duodiscus92/projet-ouah/datasheets/upduino-pinout.png

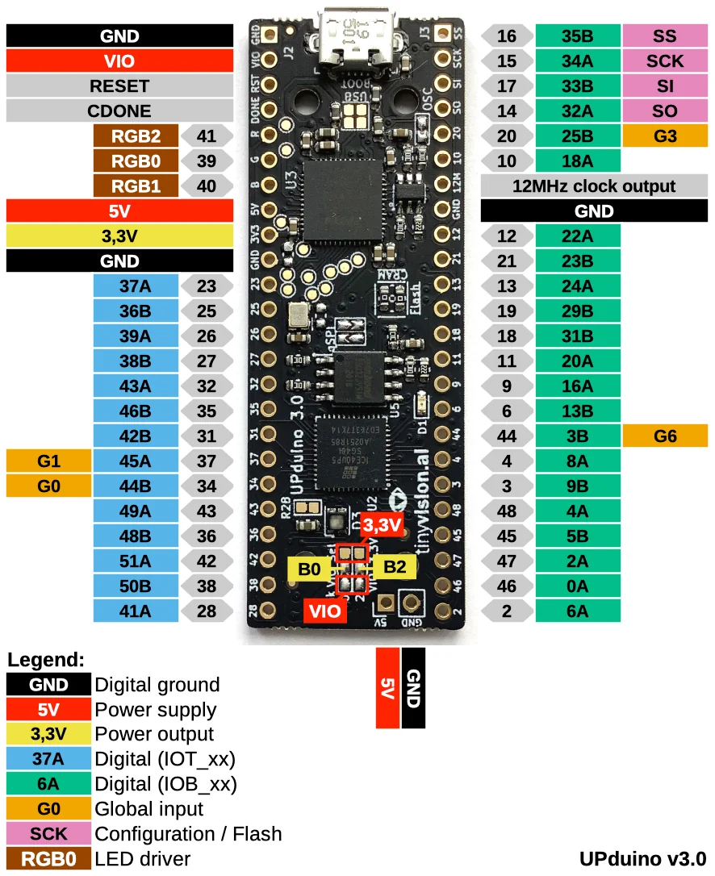
datasheets/upduino-pinout.png
