duodiscus92/projet-ouah/kicad/rapport-equipotentielles.csv

Net Code | Nom Équipot | Nombre de Pads | Nombre de Vias | Longueur de Via | Longueur de Segment | Dist. Pad à Chip | Longueur Net
001 | Net-(C1-Pad1) | 3 | 0 | 0,0000 mm | 28,2006 mm | 0,0000 mm | 28,2006 mm
002 | GND | 21 | 0 | 0,0000 mm | 298,6810 mm | 0,0000 mm | 298,6810 mm
003 | +9V | 4 | 0 | 0,0000 mm | 15,5298 mm | 0,0000 mm | 15,5298 mm
004 | +5V | 5 | 1 | 1,5450 mm | 110,4767 mm | 0,0000 mm | 112,0217 mm
005 | Net-(D1-Pad2) | 2 | 0 | 0,0000 mm | 8,7160 mm | 0,0000 mm | 8,7160 mm
006 | Net-(D1-Pad4) | 2 | 0 | 0,0000 mm | 40,1498 mm | 0,0000 mm | 40,1498 mm
007 | Net-(D4-Pad2) | 2 | 0 | 0,0000 mm | 5,8661 mm | 0,0000 mm | 5,8661 mm
008 | Net-(D5-Pad2) | 2 | 0 | 0,0000 mm | 5,8781 mm | 0,0000 mm | 5,8781 mm
009 | Net-(D6-Pad2) | 2 | 0 | 0,0000 mm | 5,8781 mm | 0,0000 mm | 5,8781 mm
010 | Net-(D7-Pad2) | 2 | 0 | 0,0000 mm | 5,8760 mm | 0,0000 mm | 5,8760 mm
011 | Net-(D8-Pad2) | 2 | 0 | 0,0000 mm | 5,8781 mm | 0,0000 mm | 5,8781 mm
012 | Net-(D9-Pad2) | 2 | 0 | 0,0000 mm | 5,8760 mm | 0,0000 mm | 5,8760 mm
013 | Net-(D10-Pad2) | 2 | 0 | 0,0000 mm | 5,8781 mm | 0,0000 mm | 5,8781 mm
014 | /R_DCF77 | 2 | 0 | 0,0000 mm | 19,5484 mm | 0,0000 mm | 19,5484 mm
015 | /S_DCF77 | 2 | 0 | 0,0000 mm | 13,0167 mm | 0,0000 mm | 13,0167 mm
016 | Net-(D13-Pad2) | 2 | 0 | 0,0000 mm | 5,4669 mm | 0,0000 mm | 5,4669 mm
018 | /DCF77 | 2 | 0 | 0,0000 mm | 112,5843 mm | 0,0000 mm | 112,5843 mm
019 | /cs3 | 2 | 4 | 6,1800 mm | 102,3684 mm | 0,0000 mm | 108,5484 mm
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
077 | Net-(F1-Pad1) | 2 | 0 | 0,0000 mm | 13,0006 mm | 0,0000 mm | 13,0006 mm
078 | Net-(F1-Pad2) | 2 | 0 | 0,0000 mm | 10,7071 mm | 0,0000 mm | 10,7071 mm
079 | Net-(J2-Pad3) | 2 | 0 | 0,0000 mm | 40,4527 mm | 0,0000 mm | 40,4527 mm
