duodiscus92/projet-ouah/kicad/Ouah 3D.jpg

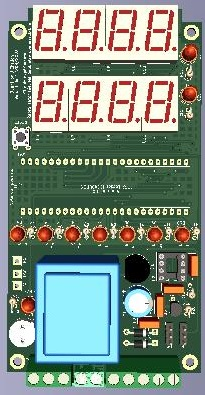
kicad/Ouah 3D.jpg
