duodiscus92/projet-ouah/documentation/bom.xls

Column2 | Column3 | Column4 | Column5 | Column6 | Column7
Qty | Reference(s) | Value | LibPart | Footprint | Datasheet
1 | C1 | 470 uF | Device:C_Polarized | Capacitor_THT:CP_Radial_D10.0mm_P5.00mm | ~
1 | C2 | 100 nF | Device:C | Capacitor_THT:C_Rect_L7.2mm_W2.5mm_P5.00mm_FKS2_FKP2_MKS2_MKP2 | ~
2 | C3, C6 | 100 nF | Device:C | Capacitor_THT:C_Rect_L7.2mm_W2.5mm_P5.00mm_FKS2_FKP2_MKS2_MKP2 | ~
1 | C4 | 100nF | Device:C | Capacitor_THT:C_Rect_L7.2mm_W2.5mm_P5.00mm_FKS2_FKP2_MKS2_MKP2 | ~
1 | C5 | 100nF | Device:C | Capacitor_THT:C_Rect_L7.2mm_W2.5mm_P5.00mm_FKS2_FKP2_MKS2_MKP2 | ~
1 | D1 | B250C1500G | Diode_Bridge:B250C1500G | Diode_THT:Diode_Bridge_Round_D9.8mm | https://www.vishay.com/docs/88501/b40c1500g.pdf
1 | D2 | 1N4007 | Diode:1N4007 | Diode_THT:D_DO-41_SOD81_P10.16mm_Horizontal | http://www.vishay.com/docs/88503/1n4001.pdf
1 | D3 | 1N4007 | Diode:1N4007 | Diode_THT:D_DO-41_SOD81_P10.16mm_Horizontal | http://www.vishay.com/docs/88503/1n4001.pdf
1 | D4 | LED | Device:LED | LED_THT:LED_D5.0mm | ~
1 | D5 | LED | Device:LED | LED_THT:LED_D5.0mm | ~
1 | D6 | LED | Device:LED | LED_THT:LED_D5.0mm | ~
1 | D7 | LED | Device:LED | LED_THT:LED_D5.0mm | ~
1 | D8 | LED | Device:LED | LED_THT:LED_D5.0mm | ~
1 | D9 | LED | Device:LED | LED_THT:LED_D5.0mm | ~
1 | D10 | LED | Device:LED | LED_THT:LED_D5.0mm | ~
1 | D11 | LED | Device:LED | LED_THT:LED_D5.0mm | ~
1 | D12 | LED | Device:LED | LED_THT:LED_D5.0mm | ~
1 | D13 | LED | Device:LED | LED_THT:LED_D5.0mm | ~
1 | F1 | LITT 37201000411 | Fusible radial 100 mA retardé | Fuse:Fuseholder_TR5_Littelfuse_No560_No460 | ~
1 | J1 | Screw_Terminal_01x05 | Bornier à vis 5 pôles | TerminalBlock:TerminalBlock_bornier-5_P5.08mm | ~
1 | J2 | Screw_Terminal_01x03 | Bornier à vis 3 pôles | TerminalBlock:TerminalBlock_bornier-3_P5.08mm | ~
1 | J3 | Screw_Terminal_01x02 | Bornier à vis 2 pôles | TerminalBlock:TerminalBlock_bornier-2_P5.08mm | ~
1 | JP1 | Jumper_3_Open | Jumper:Jumper_3_Open | Connector_PinHeader_2.54mm:PinHeader_1x03_P2.54mm_Vertical | ~
1 | JP2 | Jumper_3_Open | Jumper:Jumper_3_Open | Connector_PinHeader_2.54mm:PinHeader_1x03_P2.54mm_Vertical | ~
1 | JP3 | Jumper_2_Open | Jumper:Jumper_2_Open | Connector_PinHeader_2.54mm:PinHeader_1x02_P2.54mm_Vertical | ~
1 | R1 | 150 ohms | Device:R | Resistor_THT:R_Axial_DIN0207_L6.3mm_D2.5mm_P7.62mm_Horizontal | ~
1 | R2 | 150 ohms | Device:R | Resistor_THT:R_Axial_DIN0207_L6.3mm_D2.5mm_P7.62mm_Horizontal | ~
1 | R3 | 150 ohms | Device:R | Resistor_THT:R_Axial_DIN0207_L6.3mm_D2.5mm_P2.54mm_Vertical | ~
1 | R4 | 150 ohms | Device:R | Resistor_THT:R_Axial_DIN0207_L6.3mm_D2.5mm_P7.62mm_Horizontal | ~
1 | R5 | 150 ohms | Device:R | Resistor_THT:R_Axial_DIN0207_L6.3mm_D2.5mm_P7.62mm_Horizontal | ~
1 | R6 | 150 ohms | Device:R | Resistor_THT:R_Axial_DIN0207_L6.3mm_D2.5mm_P2.54mm_Vertical | ~
1 | R7 | 150 ohms | Device:R | Resistor_THT:R_Axial_DIN0207_L6.3mm_D2.5mm_P2.54mm_Vertical | ~
1 | R8 | 150 ohms | Device:R | Resistor_THT:R_Axial_DIN0207_L6.3mm_D2.5mm_P2.54mm_Vertical | ~
1 | R9 | 150 ohms | Device:R | Resistor_THT:R_Axial_DIN0207_L6.3mm_D2.5mm_P7.62mm_Horizontal | ~
1 | R10 | 150 ohms | Device:R | Resistor_THT:R_Axial_DIN0207_L6.3mm_D2.5mm_P7.62mm_Horizontal | ~
1 | R11 | 150 ohms | Device:R | Resistor_THT:R_Axial_DIN0207_L6.3mm_D2.5mm_P2.54mm_Vertical | ~
1 | R12 | 150 ohms | Device:R | Resistor_THT:R_Axial_DIN0207_L6.3mm_D2.5mm_P2.54mm_Vertical | ~
1 | R13 | 150 ohms | Device:R | Resistor_THT:R_Axial_DIN0207_L6.3mm_D2.5mm_P2.54mm_Vertical | ~
1 | R14 | 150 ohms | Device:R | Resistor_THT:R_Axial_DIN0207_L6.3mm_D2.5mm_P7.62mm_Horizontal | ~
1 | R15 | 150 ohms | Device:R | Resistor_THT:R_Axial_DIN0207_L6.3mm_D2.5mm_P7.62mm_Horizontal | ~
1 | R16 | 150 ohms | Device:R | Resistor_THT:R_Axial_DIN0207_L6.3mm_D2.5mm_P2.54mm_Vertical | ~
1 | R17 | 150 ohms | Device:R | Resistor_THT:R_Axial_DIN0207_L6.3mm_D2.5mm_P2.54mm_Vertical | ~
1 | R18 | 150 ohms | Device:R | Resistor_THT:R_Axial_DIN0207_L6.3mm_D2.5mm_P2.54mm_Vertical | ~
1 | R19 | 10k | Device:R | Resistor_THT:R_Axial_DIN0207_L6.3mm_D2.5mm_P2.54mm_Vertical | ~
1 | R20 | 10k | Device:R | Resistor_THT:R_Axial_DIN0207_L6.3mm_D2.5mm_P2.54mm_Vertical | ~
1 | SW1 | SW_Push | Switch:SW_Push | Button_Switch_THT:SW_PUSH_6mm | ~
1 | T1 | BLOCK VB 1,0/1/9 | Device:Transformer_1P_1S | Library:Transformer_CHK_EI30-2VA_1xSec_RevEHR | ~
1 | TP1 | TestPoint | Connector:TestPoint | TestPoint:TestPoint_THTPad_3.0x3.0mm_Drill1.5mm | ~
1 | TP2 | TestPoint | Connector:TestPoint | TestPoint:TestPoint_THTPad_3.0x3.0mm_Drill1.5mm | ~
1 | TP3 | TestPoint | Connector:TestPoint | TestPoint:TestPoint_THTPad_3.0x3.0mm_Drill1.5mm | ~
1 | U1 | Upduino31-v3 | Carte Upduino 3.0 | Library:DIP-48_W17.78mm_LongPads
1 | U2 | TL7705A | Power_Supervisor:TL7705A | Package_DIP:DIP-8_W7.62mm_Socket_LongPads | http://www.ti.com.cn/cn/lit/ds/symlink/tl7705a.pdf
1 | U3 | LP2950-5.0_TO92 | Regulator_Linear:LP2950-5.0_TO92 | Package_TO_SOT_THT:TO-92_Inline_Wide | http://www.ti.com/lit/ds/symlink/lp2951.pdf
1 | U4 | D168K | Afficheur 7 segment, cathode commune | Library:D1X8K_RevEHR | https://ia800903.us.archive.org/24/items/CTKD1x8K/Cromatek%20D168K.pdf
1 | U5 | D168K | Afficheur 7 segment, cathode commune | Library:D1X8K_RevEHR | https://ia800903.us.archive.org/24/items/CTKD1x8K/Cromatek%20D168K.pdf
1 | U6 | D168K | Afficheur 7 segment, cathode commune | Library:D1X8K_RevEHR | https://ia800903.us.archive.org/24/items/CTKD1x8K/Cromatek%20D168K.pdf
1 | U7 | D168K | Afficheur 7 segment, cathode commune | Library:D1X8K_RevEHR | https://ia800903.us.archive.org/24/items/CTKD1x8K/Cromatek%20D168K.pdf
1 | U8 | D168K | Afficheur 7 segment, cathode commune | Library:D1X8K_RevEHR | https://ia800903.us.archive.org/24/items/CTKD1x8K/Cromatek%20D168K.pdf
1 | U9 | D168K | Afficheur 7 segment, cathode commune | Library:D1X8K_RevEHR | https://ia800903.us.archive.org/24/items/CTKD1x8K/Cromatek%20D168K.pdf
1 | U10 | D168K | Afficheur 7 segment, cathode commune | Library:D1X8K_RevEHR | https://ia800903.us.archive.org/24/items/CTKD1x8K/Cromatek%20D168K.pdf
1 | U11 | D168K | Afficheur 7 segment, cathode commune | Library:D1X8K_RevEHR | https://ia800903.us.archive.org/24/items/CTKD1x8K/Cromatek%20D168K.pdf
Qty | Reference(s) | Value | LibPart | Footprint | Datasheet
1 | C1 | 470 uF | Condensateur polarisé | Capacitor_THT:CP_Radial_D10.0mm_P5.00mm | ~
4 | C2, C3 | 100 nF | Condensateurs | Capacitor_THT:C_Rect_L7.2mm_W2.5mm_P5.00mm_FKS2_FKP2_MKS2_MKP2 | ~
1 | D1 | B250C1500G | Pont à diodes | Diode_THT:Diode_Bridge_Round_D9.8mm | https://www.vishay.com/docs/88501/b40c1500g.pdf
2 | D2, D3 | 1N4007 | Diode:1N4007 | Diode_THT:D_DO-41_SOD81_P10.16mm_Horizontal | http://www.vishay.com/docs/88503/1n4001.pdf
10 | D4, D5, D6, D7, D8, D9, D10, D11, D12, D13 | LED | Device:LED | LED_THT:LED_D5.0mm | ~
1 | F1 | LITT 37201000411 | Fusible radial 100 mA retardé | Fuse:Fuseholder_TR5_Littelfuse_No560_No460 | ~
1 | J1 | Screw_Terminal_01x05 | Bornier à vis 5 pôles | TerminalBlock:TerminalBlock_bornier-5_P5.08mm | ~
1 | J2 | Screw_Terminal_01x03 | Bornier à vis 3 pôles | TerminalBlock:TerminalBlock_bornier-3_P5.08mm | ~
1 | J3 | Screw_Terminal_01x02 | Bornier à vis 2 pôles | TerminalBlock:TerminalBlock_bornier-2_P5.08mm | ~
2 | JP1, JP2 | Jumper_3_Open | Jumper:Jumper_3_Open | Connector_PinHeader_2.54mm:PinHeader_1x03_P2.54mm_Vertical | ~
1 | JP3 | Jumper_2_Open | Jumper:Jumper_2_Open | Connector_PinHeader_2.54mm:PinHeader_1x02_P2.54mm_Vertical | ~
8 | R1, R2, R4, R5, R9, R10, R14, R15 | 150 | Device:R | Resistor_THT:R_Axial_DIN0207_L6.3mm_D2.5mm_P7.62mm_Horizontal | ~
10 | R3, R6, R7, R8, R11, R12, R13, R16, R17, R18 | 150 | Device:R | Resistor_THT:R_Axial_DIN0207_L6.3mm_D2.5mm_P2.54mm_Vertical | ~
2 | R19, R20 | 10k | Device:R | Resistor_THT:R_Axial_DIN0207_L6.3mm_D2.5mm_P2.54mm_Vertical | ~
1 | SW1 | SW_Push | Bouton Push | Button_Switch_THT:SW_PUSH_6mm | ~
1 | T1 | BLOCK VB 1,0/1/9 | Device:Transformer_1P_1S | Library:Transformer_CHK_EI30-2VA_1xSec_RevEHR | ~
3 | TP1, TP2, TP3 | TestPoint | Connector:TestPoint | TestPoint:TestPoint_THTPad_3.0x3.0mm_Drill1.5mm | ~
1 | U1 | Upduino31-v3 | Carte Upduino 3.0 | Library:DIP-48_W17.78mm_LongPads
1 | U2 | TL7705A | Power_Supervisor:TL7705A | Package_DIP:DIP-8_W7.62mm_Socket_LongPads | http://www.ti.com.cn/cn/lit/ds/symlink/tl7705a.pdf
2 | U3, U12 | LP2950-5.0_TO92 | Regulator_Linear:LP2950-5.0_TO92 | Package_TO_SOT_THT:TO-92_Inline_Wide | http://www.ti.com/lit/ds/symlink/lp2951.pdf
8 | U4, U5, U6, U7, U8, U9, U10, U11 | D168K | Afficheurs 7 segments | Library:D1X8K_RevEHR | https://ia800903.us.archive.org/24/items/CTKD1x8K/Cromatek%20D168K.pdf
