duodiscus92/projet-ouah/documentation/passe-bande-butterworth-77500Hz.ASC

C1: cap; 0.026785µF; Rpar=153.338k
C2: cap; 1057.35pF; Rpar=3.884Meg
C3: cap; 0.026105µF; Rpar=157.336k
C4: cap; 680.507pF; Rpar=6.036Meg
C5: cap; 0.026105µF; Rpar=157.336k
C6: cap; 1057.35pF; Rpar=3.884Meg
C7: cap; 0.026785µF; Rpar=153.338k
L1: ind; 151.47µH; Rser=0.3687879
L3: ind; 151.47µH; Rser=0.3687879
L5: ind; 151.47µH; Rser=0.3687879
L7: ind; 151.47µH; Rser=0.3687879
RL: res; 1.25k
RS: res; 1.25k
Vgen: voltage; AC 2
Named nets: 0
.AC DEC 1000  50000  90000
Schematic drawn by Elsie
1
2
3
4
5
6
7
