duodiscus92/projet-ouah/documentation/passe-bas-80kHz.ASC

C1: cap; 0,024uF
C3: cap; 0,082uF
C5: cap; 0,024uF
L2: ind; 160uH; Rser=8,042477E-05
L4: ind; 160uH; Rser=8,042477E-05
RL: res; 50
RS: res; 50
Vgen: voltage; AC 2
