duodiscus92/projet-ouah/documentation/passe-haut-70kHz.ASC

C1: cap; 0,075uF
C3: cap; 0,022uF
C5: cap; 0,075uF
L2: ind; 70,2594uH; Rser=3,09017E-05
L4: ind; 70,2594uH; Rser=3,09017E-05
RL: res; 50
RS: res; 50
Vgen: voltage; AC 2
