duodiscus92/projet-ouah/kicad/Ouah.kicad_pcb

## KiCad design kicad/Ouah.kicad_pcb (2023-11-12)

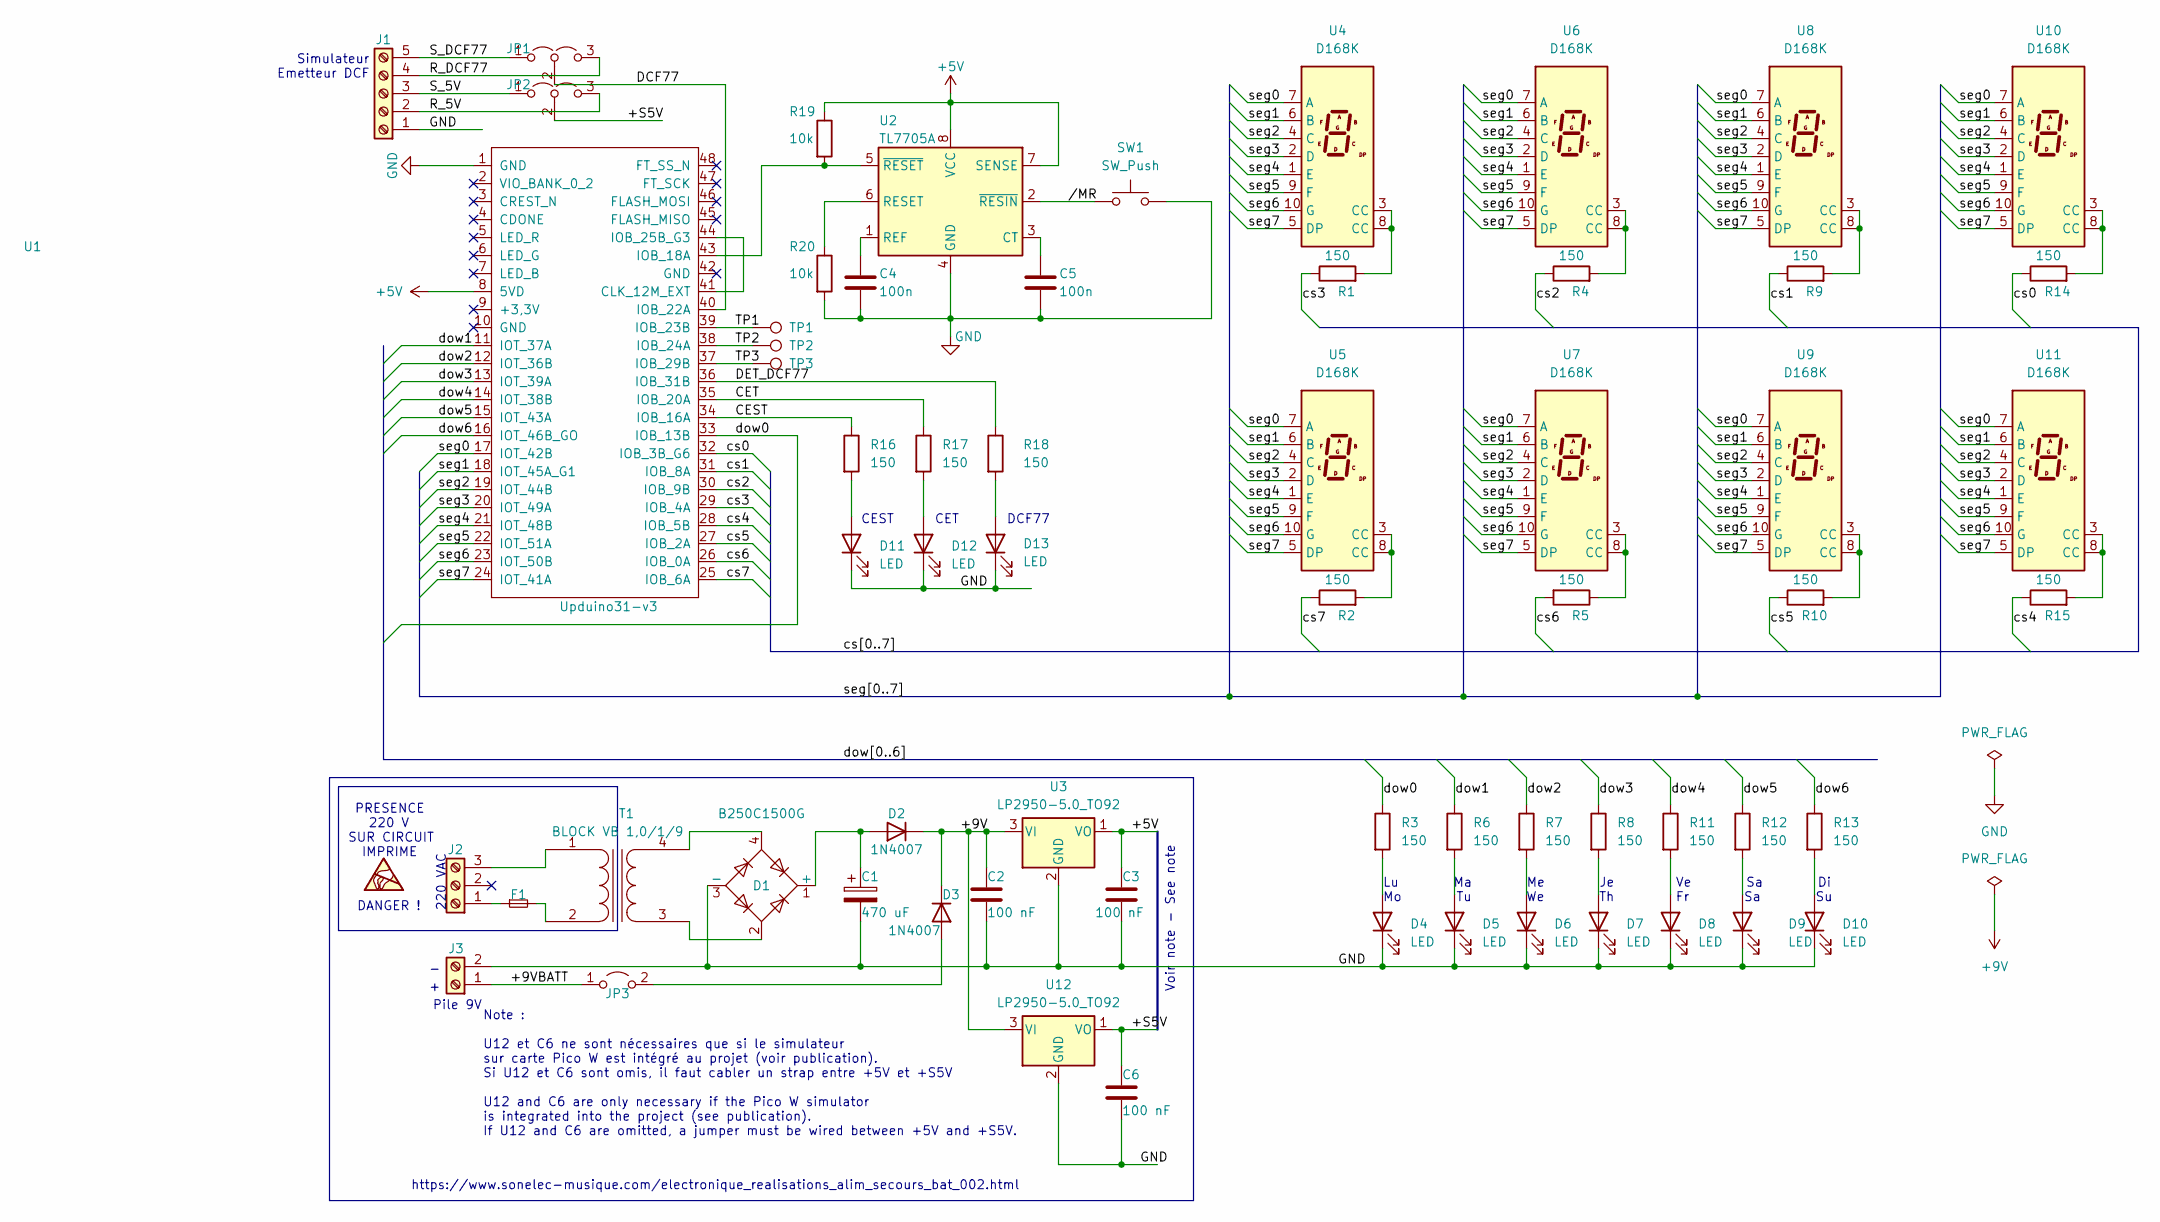
[picture p19: schematic Ouah.kicad_sch, Ouah ! (Oh ! Une Autre Horloge)]

Parts:
C1: 470 uF; CP_Radial_D10.0mm_P5.00mm
C2, C3, C6: 100 nF; C_Rect_L7.2mm_W2.5mm_P5.00mm_FKS2_FKP2_MKS2_MKP2
C4, C5: 100n; C_Rect_L7.2mm_W2.5mm_P5.00mm_FKS2_FKP2_MKS2_MKP2
D1: B250C1500G; Diode_Bridge_Round_D9.8mm
D2, D3: 1N4007; D_DO-41_SOD81_P10.16mm_Horizontal
D4, D5, D6, D7, D8, D9, D10, D11, D12, D13: LED; LED_D5.0mm
F1: Fuse_Small; Fuseholder_TR5_Littelfuse_No560_No460
J1: Screw_Terminal_01x05; TerminalBlock_bornier-5_P5.08mm
J2: Screw_Terminal_01x03; TerminalBlock_bornier-3_P5.08mm
J3: Screw_Terminal_01x02; TerminalBlock_bornier-2_P5.08mm
JP1, JP2: Jumper_3_Open; PinHeader_1x03_P2.54mm_Vertical
JP3: Jumper_2_Open; PinHeader_1x02_P2.54mm_Vertical
R1, R2, R4, R5, R9, R10, R14, R15: 150; R_Axial_DIN0207_L6.3mm_D2.5mm_P7.62mm_Horizontal
R3, R6, R7, R8, R11, R12, R13, R16, R17, R18: 150; R_Axial_DIN0207_L6.3mm_D2.5mm_P2.54mm_Vertical
R19, R20: 10k; R_Axial_DIN0207_L6.3mm_D2.5mm_P2.54mm_Vertical
SW1: SW_Push; SW_PUSH_6mm
T1: BLOCK VB 1,0/1/9; Transformer_CHK_EI30-2VA_1xSec_RevEHR
TP1, TP2, TP3: TestPoint; TestPoint_THTPad_3.0x3.0mm_Drill1.5mm
U1: Upduino31-v3; DIP-48_W17.78mm_LongPads
U2: TL7705A; DIP-8_W7.62mm_Socket_LongPads
U3, U12: LP2950-5.0_TO92; TO-92_Inline_Wide
U4, U5, U6, U7, U8, U9, U10, U11: D168K; D1X8K_RevEHR

Connections:
+5V: C3.2, R19.1, U1.8 (5VD), U2.7 (SENSE), U2.8 (VCC), U3.1 (VO)
+9V: C2.2, D2.1 (K), D3.1 (K), U3.3 (VI), U12.3 (VI)
/+9VBATT: J3.1, JP3.1 (A)
/+S5V: C6.2, JP2.2 (C), U12.1 (VO)
/CEST: R16.1, U1.34 (IOB_16A)
/CET: R17.1, U1.35 (IOB_20A)
/DCF77: JP1.2 (C), U1.40 (IOB_22A)
/DET_DCF77: R18.1, U1.36 (IOB_31B)
/R_5V: J1.2, JP2.3 (B)
/R_DCF77: J1.4, JP1.3 (B)
/S_5V: J1.3, JP2.1 (A)
/S_DCF77: J1.5, JP1.1 (A)
/TP1: TP1.1, U1.39 (IOB_23B)
/TP2: TP2.1, U1.38 (IOB_24A)
/TP3: TP3.1, U1.37 (IOB_29B)
/cs0: R14.1, U1.32 (IOB_3B_G6)
/cs1: R9.1, U1.31 (IOB_8A)
/cs2: R4.1, U1.30 (IOB_9B)
/cs3: R1.1, U1.29 (IOB_4A)
/cs4: R15.1, U1.28 (IOB_5B)
/cs5: R10.1, U1.27 (IOB_2A)
/cs6: R5.2, U1.26 (IOB_0A)
/cs7: R2.1, U1.25 (IOB_6A)
/dow0: R3.1, U1.33 (IOB_13B)
/dow1: R6.1, U1.11 (IOT_37A)
/dow2: R7.1, U1.12 (IOT_36B)
/dow3: R8.1, U1.13 (IOT_39A)
/dow4: R11.1, U1.14 (IOT_38B)
/dow5: R12.1, U1.15 (IOT_43A)
/dow6: R13.1, U1.16 (IOT_46B_GO)
/seg0: U1.17 (IOT_42B), U4.7 (A), U5.7 (A), U6.7 (A), U7.7 (A), U8.7 (A), U9.7 (A), U10.7 (A), U11.7 (A)
/seg1: U1.18 (IOT_45A_G1), U4.6 (B), U5.6 (B), U6.6 (B), U7.6 (B), U8.6 (B), U9.6 (B), U10.6 (B), U11.6 (B)
/seg2: U1.19 (IOT_44B), U4.4 (C), U5.4 (C), U6.4 (C), U7.4 (C), U8.4 (C), U9.4 (C), U10.4 (C), U11.4 (C)
/seg3: U1.20 (IOT_49A), U4.2 (D), U5.2 (D), U6.2 (D), U7.2 (D), U8.2 (D), U9.2 (D), U10.2 (D), U11.2 (D)
/seg4: U1.21 (IOT_48B), U4.1 (E), U5.1 (E), U6.1 (E), U7.1 (E), U8.1 (E), U9.1 (E), U10.1 (E), U11.1 (E)
/seg5: U1.22 (IOT_51A), U4.9 (F), U5.9 (F), U6.9 (F), U7.9 (F), U8.9 (F), U9.9 (F), U10.9 (F), U11.9 (F)
/seg6: U1.23 (IOT_50B), U4.10 (G), U5.10 (G), U6.10 (G), U7.10 (G), U8.10 (G), U9.10 (G), U10.10 (G), U11.10 (G)
/seg7: U1.24 (IOT_41A), U4.5 (DP), U5.5 (DP), U6.5 (DP), U7.5 (DP), U8.5 (DP), U9.5 (DP), U10.5 (DP), U11.5 (DP)
//MR: SW1.1, U2.2 (~RESIN)
GND: C1.2, C2.1, C3.1, C4.2, C5.2, C6.1, D1.3 (-), D4.1 (K), D5.1 (K), D6.1 (K), D7.1 (K), D8.1 (K), D9.1 (K), D10.1 (K), D11.1 (K), D12.1 (K), D13.1 (K), J1.1, J3.2, R20.2, SW1.2, U1.1 (GND), U2.4 (GND), U3.2 (GND), U12.2 (GND)
unnamed: C1.1, D1.1 (+), D2.2 (A)
unnamed: C4.1, U2.1 (REF)
unnamed: C5.1, U2.3 (CT)
unnamed: D1.2, T1.3 (SA)
unnamed: D1.4, T1.4 (SB)
unnamed: D3.2 (A), JP3.2 (B)
unnamed: D4.2 (A), R3.2
unnamed: D5.2 (A), R6.2
unnamed: D6.2 (A), R7.2
unnamed: D7.2 (A), R8.2
unnamed: D8.2 (A), R11.2
unnamed: D9.2 (A), R12.2
unnamed: D10.2 (A), R13.2
unnamed: D11.2 (A), R16.2
unnamed: D12.2 (A), R17.2
unnamed: D13.2 (A), R18.2
unnamed: F1.1, J2.1
unnamed: F1.2, T1.2 (AB)
unnamed: J2.3, T1.1 (AA)
unnamed: R1.2, U4.3 (CC), U4.8 (CC)
unnamed: R2.2, U5.3 (CC), U5.8 (CC)
unnamed: R4.2, U6.3 (CC), U6.8 (CC)
unnamed: R5.1, U7.3 (CC), U7.8 (CC)
unnamed: R9.2, U8.3 (CC), U8.8 (CC)
unnamed: R10.2, U9.3 (CC), U9.8 (CC)
unnamed: R14.2, U10.3 (CC), U10.8 (CC)
unnamed: R15.2, U11.3 (CC), U11.8 (CC)
unnamed: R19.2, U1.43 (IOB_18A), U2.5 (~RESET)
unnamed: R20.1, U2.6 (RESET)
unnamed: U1.41 (CLK_12M_EXT), U1.44 (IOB_25B_G3)

Notes on the sheet:
Note : U12 et C6 ne sont nécessaires que si le simulateur sur carte Pico W est intégré au projet (voir publication). Si U12 et C6 sont omis, il faut cabler un strap entre +5V et +S5V U12 and C6 are only necessary if the Pico W simulator is integrated into the project (see publication). If U12 and C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
Voir note - See note
Simulateur Emetteur DCF
DANGER !
PRESENCE 220 V SUR CIRCUIT IMPRIME
https://www.sonelec-musique.com/electronique_realisations_alim_secours_bat_002.html
Pile 9V
220 VAC
CEST CET DCF77
Lu Ma Me Je Ve Sa Di Mo Tu We Th Fr Sa Su

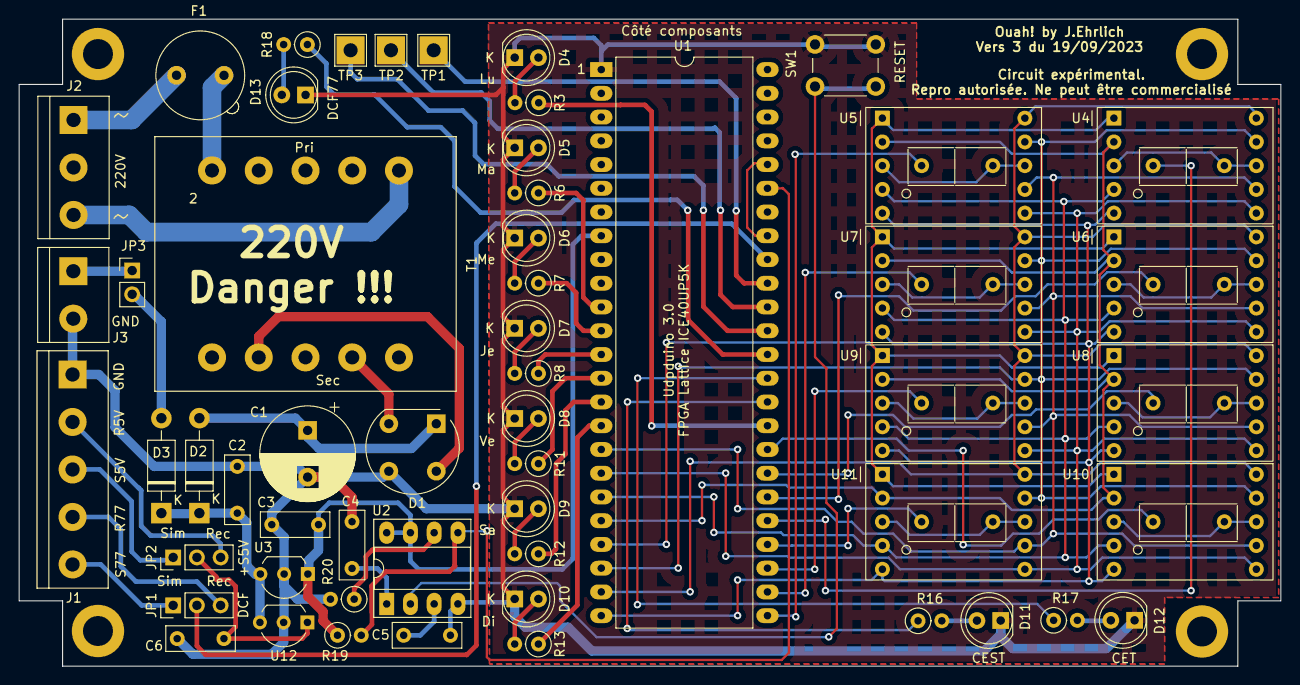
[picture p20: board Ouah.kicad_pcb from above]

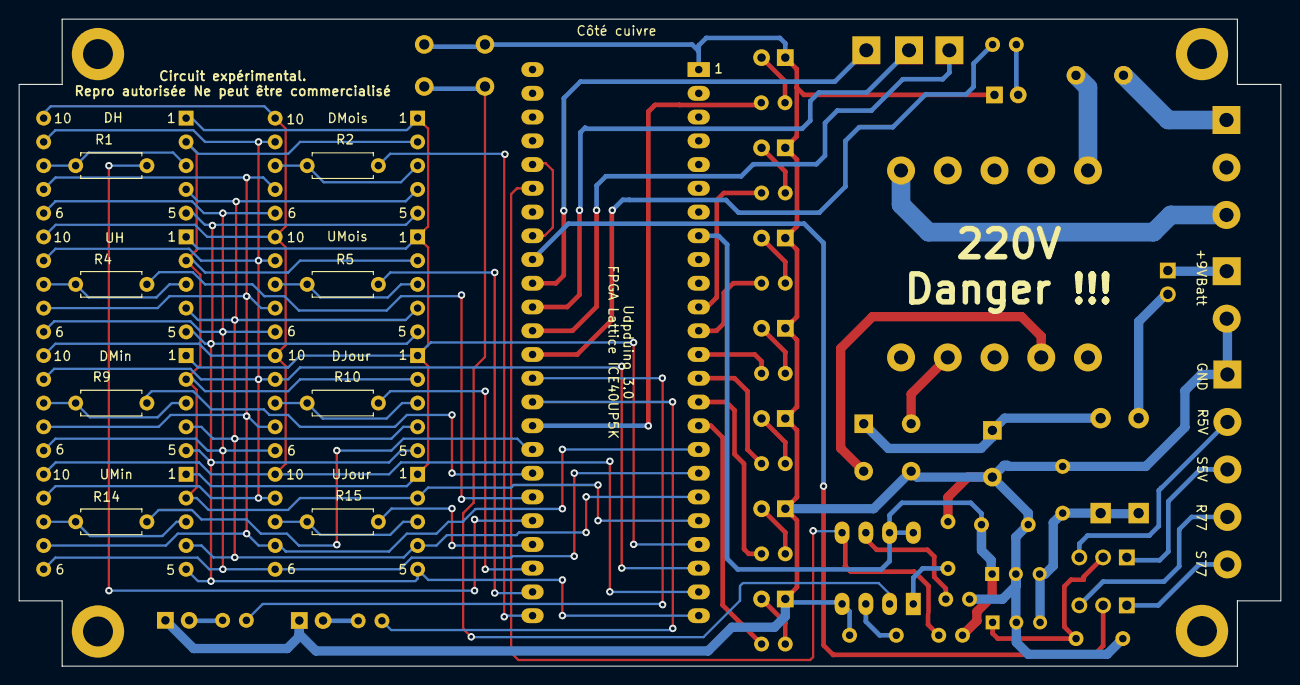
[picture p21: board Ouah.kicad_pcb from below]

Board: 2 copper layers, 135.0 x 69.2 mm, 66 parts (8 on the bottom side), 70 nets.

Other parts of the board:
1, 2, 3: (no value)
